dineshannayya/riscduino_dcore/signoff/user_project_wrapper/final_summary_report.csv

 | design | design_name | config | flow_status | total_runtime | routed_runtime | (Cell/mm^2)/Core_Util | DIEAREA_mm^2 | CellPer_mm^2 | OpenDP_Util | Peak_Memory_Usage_MB | cell_count | tritonRoute_violations | Short_violations | MetSpc_violations | OffGrid_violations | MinHole_violations | Other_violations | Magic_violations | antenna_violations | lvs_total_errors | cvc_total_errors | klayout_violations | wire_length | vias | wns | pl_wns | optimized_wns | fastroute_wns | spef_wns | tns | pl_tns | optimized_tns | fastroute_tns | spef_tns | HPWL | routing_layer1_pct | routing_layer2_pct | routing_layer3_pct | routing_layer4_pct | routing_layer5_pct | routing_layer6_pct | wires_count | wire_bits | public_wires_count | public_wire_bits | memories_count | memory_bits | processes_count | cells_pre_abc | AND | DFF | NAND | NOR | OR | XOR | XNOR | MUX | inputs
0 | /home/dinesha/workarea/opencore/git/riscduino_dcore/openlane/user_project_wrapper | user_project_wrapper | user_project_wrapper | flow completed | 0h53m49s0ms | 0h3m55s0ms | -2.0 | -1 | -1 | -1 | 555.07 | 13 | 0 | 0 | 0 | 0 | 0 | 0 | -1 | 0 | 0 | -1 | -1 | 1423269 | 10484 | 0.0 | -1 | -1 | 0.0 | 0.0 | 0.0 | -1 | -1 | 0.0 | 0.0 | -1 | 0.0 | 5.38 | 6.4 | 1.54 | 2.35 | 0.0 | 371 | 3714 | 371 | 3714 | 0 | 0 | 0 | 13 | 0 | 0 | 0 | 0 | 0 | 0 | 0 | 0 | -1
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
