dineshannayya/riscduino_dcore/signoff/uart_i2cm_usb_spi_top/final_summary_report.csv

 | design | design_name | config | flow_status | total_runtime | routed_runtime | (Cell/mm^2)/Core_Util | DIEAREA_mm^2 | CellPer_mm^2 | OpenDP_Util | Peak_Memory_Usage_MB | cell_count | tritonRoute_violations | Short_violations | MetSpc_violations | OffGrid_violations | MinHole_violations | Other_violations | Magic_violations | antenna_violations | lvs_total_errors | cvc_total_errors | klayout_violations | wire_length | vias | wns | pl_wns | optimized_wns | fastroute_wns | spef_wns | tns | pl_tns | optimized_tns | fastroute_tns | spef_tns | HPWL | routing_layer1_pct | routing_layer2_pct | routing_layer3_pct | routing_layer4_pct | routing_layer5_pct | routing_layer6_pct | wires_count | wire_bits | public_wires_count | public_wire_bits | memories_count | memory_bits | processes_count | cells_pre_abc | AND | DFF | NAND | NOR | OR | XOR | XNOR | MUX | inputs
0 | /project/openlane/uart_i2cm_usb_spi_top | uart_i2c_usb_spi_top | uart_i2cm_usb_spi_top | flow completed | 0h22m48s0ms | 0h16m17s0ms | 78025.69303583504 | 0.36975 | 39012.84651791752 | 44.35 | 1525.37 | 14425 | 0 | 0 | 0 | 0 | 0 | 0 | 0 | -1 | 0 | -1 | -1 | 702950 | 122604 | 0.0 | -0.0 | 0.0 | 0.0 | 0.0 | 0.0 | -0.0 | 0.0 | 0.0 | 0.0 | 442593619.0 | 0.0 | 56.86 | 57.94 | 21.95 | 25.41 | -1 | 10340 | 15543 | 1940 | 7056 | 0 | 0 | 0 | 11580 | 425 | 250 | 279 | 358 | 2406 | 481 | 113 | 1133 | 2832
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
