dineshannayya/riscduino_dcore/signoff/wb_interconnect/final_summary_report.csv

 | design | design_name | config | flow_status | total_runtime | routed_runtime | (Cell/mm^2)/Core_Util | DIEAREA_mm^2 | CellPer_mm^2 | OpenDP_Util | Peak_Memory_Usage_MB | cell_count | tritonRoute_violations | Short_violations | MetSpc_violations | OffGrid_violations | MinHole_violations | Other_violations | Magic_violations | antenna_violations | lvs_total_errors | cvc_total_errors | klayout_violations | wire_length | vias | wns | pl_wns | optimized_wns | fastroute_wns | spef_wns | tns | pl_tns | optimized_tns | fastroute_tns | spef_tns | HPWL | routing_layer1_pct | routing_layer2_pct | routing_layer3_pct | routing_layer4_pct | routing_layer5_pct | routing_layer6_pct | wires_count | wire_bits | public_wires_count | public_wire_bits | memories_count | memory_bits | processes_count | cells_pre_abc | AND | DFF | NAND | NOR | OR | XOR | XNOR | MUX | inputs
0 | /project/openlane/wb_interconnect | wb_interconnect | wb_interconnect | flow completed | 0h48m7s0ms | 0h42m42s0ms | 42171.98067632851 | 0.5175 | 21085.990338164254 | 18.97 | 1315.96 | 10912 | 0 | 0 | 0 | 0 | 0 | 0 | 0 | -1 | 0 | -1 | -1 | 944198 | 91561 | -1.37 | -2.18 | -1 | -2.16 | -2.45 | -101.7 | -183.14 | -1 | -234.87 | -227.37 | 766024314.0 | 0.0 | 22.5 | 51.36 | 3.09 | 22.47 | -1 | 3853 | 12872 | 637 | 9653 | 0 | 0 | 0 | 5356 | 272 | 12 | 304 | 131 | 628 | 98 | 13 | 1407 | 1758
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
