dineshannayya/riscduino_dcore/signoff/ycr2_iconnect/final_summary_report.csv

 | design | design_name | config | flow_status | total_runtime | routed_runtime | (Cell/mm^2)/Core_Util | DIEAREA_mm^2 | CellPer_mm^2 | OpenDP_Util | Peak_Memory_Usage_MB | cell_count | tritonRoute_violations | Short_violations | MetSpc_violations | OffGrid_violations | MinHole_violations | Other_violations | Magic_violations | antenna_violations | lvs_total_errors | cvc_total_errors | klayout_violations | wire_length | vias | wns | pl_wns | optimized_wns | fastroute_wns | spef_wns | tns | pl_tns | optimized_tns | fastroute_tns | spef_tns | HPWL | routing_layer1_pct | routing_layer2_pct | routing_layer3_pct | routing_layer4_pct | routing_layer5_pct | routing_layer6_pct | wires_count | wire_bits | public_wires_count | public_wire_bits | memories_count | memory_bits | processes_count | cells_pre_abc | AND | DFF | NAND | NOR | OR | XOR | XNOR | MUX | inputs
0 | /project/openlane/ycr2_iconnect | ycr2_iconnect | ycr2_iconnect | flow completed | 0h14m56s0ms | 0h10m9s0ms | 24394.736842105263 | 0.38 | 12197.368421052632 | 11.41 | 1115.72 | 4635 | 0 | 0 | 0 | 0 | 0 | 0 | 0 | 89 | 0 | 0 | -1 | 679278 | 55379 | -1.83 | -2.29 | -1 | -0.1 | -0.27 | -3.61 | -38.89 | -1 | -0.12 | -0.43 | 520617992.0 | 0.0 | 38.01 | 53.45 | 17.58 | 41.27 | -1 | 4809 | 10170 | 596 | 5894 | 0 | 0 | 0 | 5214 | 457 | 45 | 221 | 65 | 788 | 146 | 6 | 1661 | 783
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
