dineshannayya/riscduino_dcore/signoff/ycr_core_top/final_summary_report.csv

 | design | design_name | config | flow_status | total_runtime | routed_runtime | (Cell/mm^2)/Core_Util | DIEAREA_mm^2 | CellPer_mm^2 | OpenDP_Util | Peak_Memory_Usage_MB | cell_count | tritonRoute_violations | Short_violations | MetSpc_violations | OffGrid_violations | MinHole_violations | Other_violations | Magic_violations | antenna_violations | lvs_total_errors | cvc_total_errors | klayout_violations | wire_length | vias | wns | pl_wns | optimized_wns | fastroute_wns | spef_wns | tns | pl_tns | optimized_tns | fastroute_tns | spef_tns | HPWL | routing_layer1_pct | routing_layer2_pct | routing_layer3_pct | routing_layer4_pct | routing_layer5_pct | routing_layer6_pct | wires_count | wire_bits | public_wires_count | public_wire_bits | memories_count | memory_bits | processes_count | cells_pre_abc | AND | DFF | NAND | NOR | OR | XOR | XNOR | MUX | inputs
0 | /project/openlane/ycr_core_top | ycr_core_top | ycr_core_top | flow completed | 1h30m16s0ms | 1h22m51s0ms | 77214.28571428571 | 0.532 | 38607.142857142855 | 38.76 | 2318.77 | 20539 | 0 | 0 | 0 | 0 | 0 | 0 | 0 | 158 | 0 | 0 | -1 | 1266700 | 185348 | 0.0 | -8.32 | -1 | -0.56 | -0.57 | 0.0 | -7803.43 | -1 | -1.86 | -2.28 | 996539415.0 | 0.0 | 49.4 | 71.61 | 26.89 | 54.45 | -1 | 16396 | 22729 | 542 | 6775 | 0 | 0 | 0 | 19178 | 557 | 261 | 518 | 596 | 2917 | 897 | 259 | 4835 | 2528
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
