dineshannayya/riscduino_dcore/signoff/wb_host/final_summary_report.csv

 | design | design_name | config | flow_status | total_runtime | routed_runtime | (Cell/mm^2)/Core_Util | DIEAREA_mm^2 | CellPer_mm^2 | OpenDP_Util | Peak_Memory_Usage_MB | cell_count | tritonRoute_violations | Short_violations | MetSpc_violations | OffGrid_violations | MinHole_violations | Other_violations | Magic_violations | antenna_violations | lvs_total_errors | cvc_total_errors | klayout_violations | wire_length | vias | wns | pl_wns | optimized_wns | fastroute_wns | spef_wns | tns | pl_tns | optimized_tns | fastroute_tns | spef_tns | HPWL | routing_layer1_pct | routing_layer2_pct | routing_layer3_pct | routing_layer4_pct | routing_layer5_pct | routing_layer6_pct | wires_count | wire_bits | public_wires_count | public_wire_bits | memories_count | memory_bits | processes_count | cells_pre_abc | AND | DFF | NAND | NOR | OR | XOR | XNOR | MUX | inputs
0 | /project/openlane/wb_host | wb_host | wb_host | flow completed | 0h5m29s0ms | 0h3m38s0ms | 61700.84033613445 | 0.14875 | 30850.420168067227 | 37.22 | 774.82 | 4589 | 0 | 0 | 0 | 0 | 0 | 0 | 0 | 11 | 0 | 0 | -1 | 205225 | 36945 | 0.0 | -0.19 | 0.0 | 0.0 | 0.0 | 0.0 | -23.16 | 0.0 | 0.0 | 0.0 | 155719018.0 | 0.0 | 46.7 | 45.31 | 3.63 | 15.99 | -1 | 3577 | 6294 | 1049 | 3622 | 0 | 0 | 0 | 3856 | 373 | 52 | 77 | 183 | 651 | 146 | 23 | 461 | 1023
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
