dineshannayya/riscduino_dcore/signoff/ycr_intf/final_summary_report.csv

 | design | design_name | config | flow_status | total_runtime | routed_runtime | (Cell/mm^2)/Core_Util | DIEAREA_mm^2 | CellPer_mm^2 | OpenDP_Util | Peak_Memory_Usage_MB | cell_count | tritonRoute_violations | Short_violations | MetSpc_violations | OffGrid_violations | MinHole_violations | Other_violations | Magic_violations | antenna_violations | lvs_total_errors | cvc_total_errors | klayout_violations | wire_length | vias | wns | pl_wns | optimized_wns | fastroute_wns | spef_wns | tns | pl_tns | optimized_tns | fastroute_tns | spef_tns | HPWL | routing_layer1_pct | routing_layer2_pct | routing_layer3_pct | routing_layer4_pct | routing_layer5_pct | routing_layer6_pct | wires_count | wire_bits | public_wires_count | public_wire_bits | memories_count | memory_bits | processes_count | cells_pre_abc | AND | DFF | NAND | NOR | OR | XOR | XNOR | MUX | inputs
0 | /project/openlane/ycr_intf | ycr_intf | ycr_intf | flow completed | 0h57m41s0ms | 0h46m38s0ms | 61454.47530864197 | 0.5184 | 30727.237654320987 | 34.83 | 2305.55 | 15929 | 0 | 0 | 0 | 0 | 0 | 0 | 0 | 112 | 0 | 0 | -1 | 1063374 | 143989 | -18.78 | -32.57 | -1 | 0.0 | 0.0 | -14588.49 | -36722.34 | -1 | 0.0 | 0.0 | 842676749.0 | 0.0 | 54.83 | 48.23 | 29.76 | 25.87 | -1 | 8905 | 18021 | 965 | 9748 | 0 | 0 | 0 | 11577 | 578 | 105 | 288 | 275 | 1939 | 889 | 376 | 1696 | 3103
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
