dineshannayya/riscduino_dcore/(commit log)

2022-02-15 pull the git change from https://github.com/dineshannayya/riscduino.git on 15th Feb 2022 with SRAM
    [final_summary_report.csv, macro.cfg, pin_order.cfg]
2022-02-22 initial clean up
    [macro.cfg, pin_order.cfg]
2022-02-24 dual core clean up
    [final_summary_report.csv, macro.cfg, macro_placement.cfg, pin_order.cfg]
2022-02-24 clean up
    [pin_order.cfg]
2022-03-09 sspi bug fix and wb interconnect update for cross bar
    [final_summary_report.csv, macro.cfg, pin_order.cfg]
2022-03-12 usb bug fix
    [final_summary_report.csv]
2022-03-19 design fixed to take care of caravel wb address range reduced to 0xF_FFFF
    [final_summary_report.csv, pin_order.cfg]
2022-04-02 Risc 2core integration in sync with 4core
    [final_summary_report.csv, macro.cfg, macro_placement.cfg, pin_order.cfg]
2022-04-06 riscv core physical Area clean-up
    [final_summary_report.csv, macro_placement.cfg, pin_order.cfg]
2022-04-07 2nd uart core and sspi cs# increase to 4
    [final_summary_report.csv, pin_order.cfg]
2022-04-19 tapeout check fom density fix by moving sram space
    [final_summary_report.csv, macro.cfg]
2022-05-21 re-hardending with mpe5 tools set
    [final_summary_report.csv]
2022-05-29 digital pll integrated
    [macro.cfg, pin_order.cfg]
2022-06-14 icache and dcache bypass added
    [pin_order.cfg]
2022-06-15 icache and dcache bypass option added
    [pin_order.cfg]
2022-06-26 mpw-6 pdn fix
    [final_summary_report.csv]
2022-06-26 pre-check DRC fix
    [final_summary_report.csv]
2022-07-06 arudino_ascii_table test case added
2022-07-06 typo update from arudino to arduino
2022-07-07 arduino_multi_serial test case added
2022-07-08 spi cs config update to match with arduino requirement
    [final_summary_report.csv]
2022-07-21 spi isp option added
    [final_summary_report.csv, macro.cfg, pin_order.cfg]
