dineshannayya/riscduino_dcore/(notices)

Notices in the files:
verilog/dv/user_basic/user_basic_tb.v:
SPDX-FileContributor: Modified by Dinesh Annayya <dinesha@opencores.org>
